btb/BigTime/SmallTime.md

SmallTime

My watch module, made for retrofitting into vintage 70's LED watch case (circular board, 1 inch diameter).

Uses QDSP6064 bubble display

5082-7414 should be identical replacement

5082-7404 should work fine as well, only difference is placement of decimal point
