btb/BigTime/Hardware/BigTime.brd

## EAGLE design Hardware/BigTime.brd (2016-08-10)

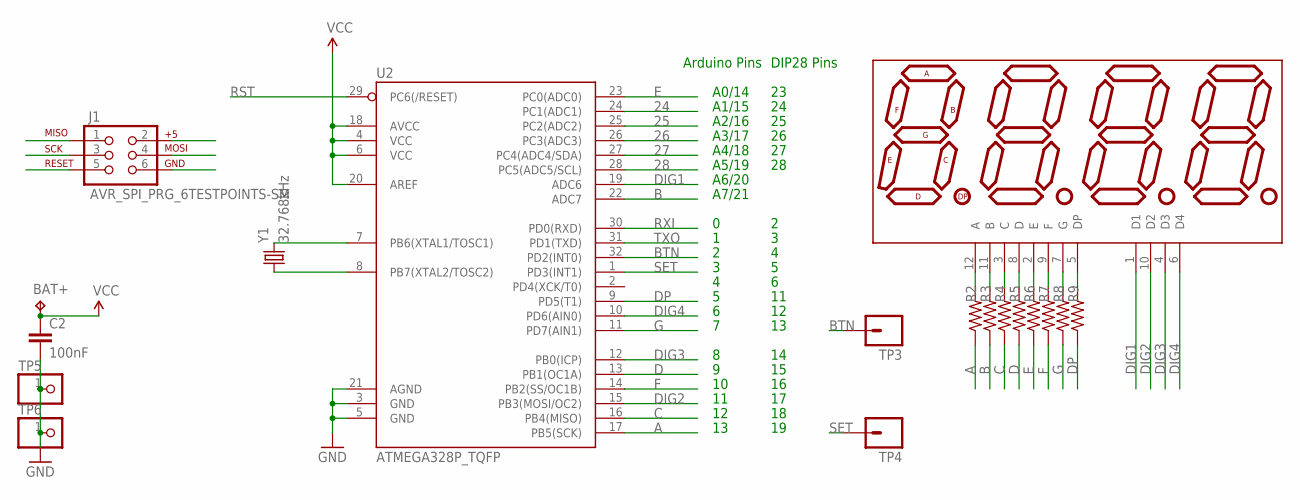
[picture p1: schematic BigTime.sch]

Parts:
BAT+: TPTP20R; TP20R
C2: 100nF; C0805
DISP1: 7-SEGMENT-4DIGIT-COUNTER-HP-BUBBLE-SM; DIL12_SM
J1: AVR_SPI_PRG_6TESTPOINTS-SM; 2X3_TEST_POINTS_SM
R2, R3, R4, R5, R6, R7, R8, R9: 330; R0805
TP3, TP4: M01EDGE_CONTACT; WATCHBTN
TP5, TP6: PINHD-1X1CB; 1X01-CLEANBIG
U2: ATMEGA328P_TQFP; TQFP32-08
Y1: 32.768kHz; TC26H

Connections:
24: U2.24 (PC1(ADC1))
25: U2.25 (PC2(ADC2))
26: U2.26 (PC3(ADC3))
27: U2.27 (PC4(ADC4/SDA))
28: U2.28 (PC5(ADC5/SCL))
A: J1.3, R2.1, U2.17 (PB5(SCK))
B: R3.1, U2.22 (ADC7)
BTN: TP3.1, U2.32 (PD2(INT0))
C: J1.1, R4.1, U2.16 (PB4(MISO))
D: R5.1, U2.13 (PB1(OC1A))
DIG1: DISP1.1 (D1), U2.19 (ADC6)
DIG2: DISP1.10 (D2), J1.4, U2.15 (PB3(MOSI/OC2))
DIG3: DISP1.4 (D3), U2.12 (PB0(ICP))
DIG4: DISP1.6 (D4), U2.10 (PD6(AIN0))
DP: R9.1, U2.9 (PD5(T1))
E: R6.1, U2.23 (PC0(ADC0))
F: R7.1, U2.14 (PB2(SS/OC1B))
G: R8.1, U2.11 (PD7(AIN1))
GND: C2.2, J1.6, TP5.1, TP6.1, U2.3 (GND), U2.5 (GND), U2.21 (AGND)
unnamed: U2.8 (PB7(XTAL2/TOSC2)), Y1.1
unnamed: U2.7 (PB6(XTAL1/TOSC1)), Y1.2
unnamed: DISP1.12 (A), R2.2
unnamed: DISP1.11 (B), R3.2
unnamed: DISP1.3 (C), R4.2
unnamed: DISP1.8 (D), R5.2
unnamed: DISP1.2 (E), R6.2
unnamed: DISP1.9 (F), R7.2
unnamed: DISP1.7 (G), R8.2
unnamed: DISP1.5 (DP), R9.2
RST: J1.5, U2.29 (PC6(/RESET))
RXI: U2.30 (PD0(RXD))
SET: TP4.1, U2.1 (PD3(INT1))
TXO: U2.31 (PD1(TXD))
VCC: BAT+.TP, C2.1, J1.2, U2.4 (VCC), U2.6 (VCC), U2.18 (AVCC), U2.20 (AREF)

Notes on the sheet:
A0/14
A1/15
A2/16
A3/17
A4/18
A5/19
Arduino Pins
DIP28 Pins
A6/20
A7/21

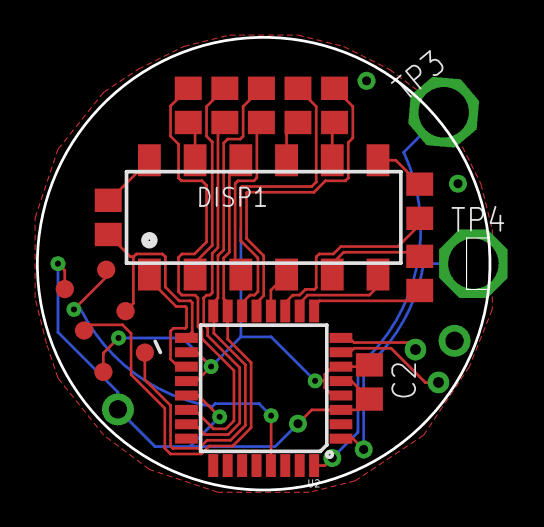
[picture p2: board BigTime.brd from above]

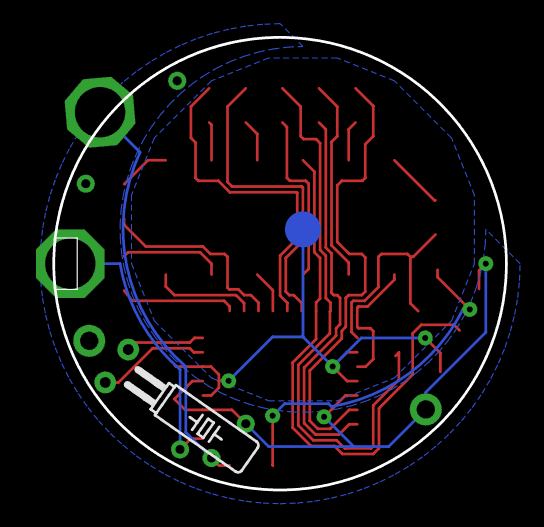
[picture p3: board BigTime.brd from below]

Board: 2 copper layers, 25.1 x 25.1 mm, 18 parts (2 on the bottom side), 27 nets.
