btb/BigTime/(commit log)

2016-06-16 replace LED with bubble display
    [BigTime.brd, BigTime.sch]
2016-06-17 Switch LED to Bubble display
2016-06-17 Correct polarity for letters
    [BigTime.ino]
2016-06-25 debug print is 24hr
2016-06-28 add set button, reroute pub
    [BigTime.brd, BigTime.sch]
2016-06-28 reset year if held down for 10 secs
    [BigTime.ino]
2016-06-29 more efficient pin arrangement
    [BigTime.brd, BigTime.sch]
2016-06-30 debounce the button interrupt
    don't let state change even if debDisp is high.
2016-07-01 rearrange pins, start fitting to size
    [BigTime.brd, BigTime.sch]
2016-07-03 fit 1" footprint
    [BigTime.brd, BigTime.sch]
2016-07-07 bigger components, no pullup on reset
    [BigTime.brd, BigTime.sch]
2016-07-19 Add new board for 45 degree button position
    [BigTime45.brd, BigTime45.sch]
2016-07-19 fix location of bStop for battery
    [BigTime45.brd]
2016-07-20 update pin numbers
2016-08-04 change to 0805 capacitor
    [BigTime45.brd, BigTime45.sch]
2016-08-09 Change board radius to .495 inch
    [BigTime45.brd]
2016-08-09 reposition disp button pad
    [BigTime45.brd]
2016-08-10 more button work
    [BigTime45.brd, BigTime45.sch]
2016-08-10 move crystal and ground pads
    [BigTime.brd]
